calm4git/210043-CO2-Guard/Hardware/Project_KiCad6/CO2Guard/CO2Guard.step

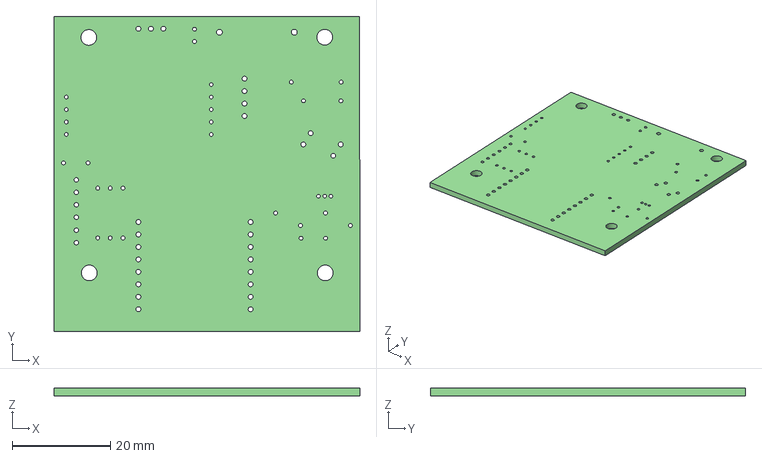
[picture p2: CAD file, 2022-01-18]
Hardware/Project_KiCad6/CO2Guard/CO2Guard.step
62.3 x 64.2 x 1.60 mm
