calm4git/210043-CO2-Guard/Enclosure/Enclosure_R4.FCStd

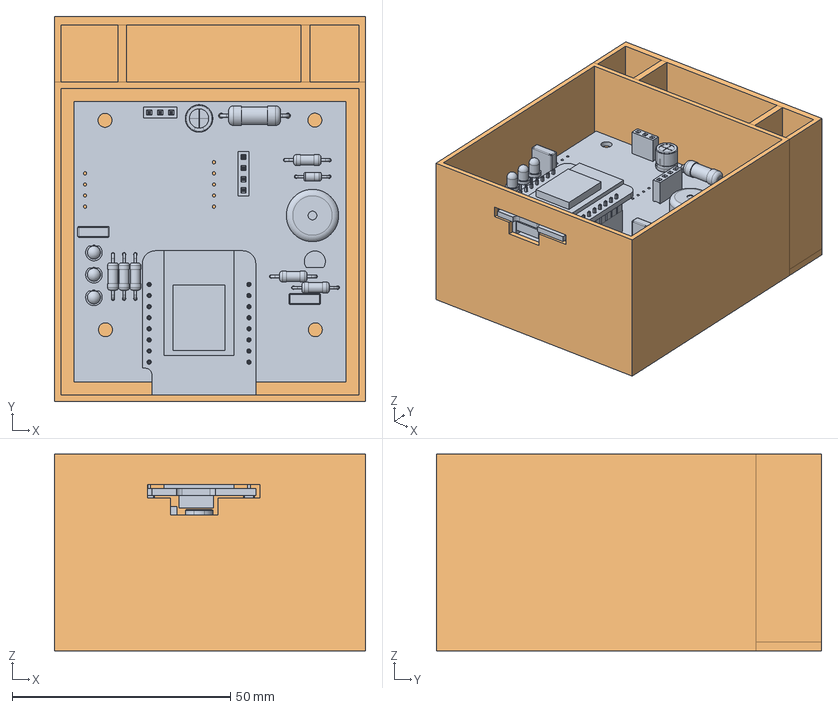
[picture p3: CAD file, 2022-01-18]
Enclosure/Enclosure_R4.FCStd
71.2 x 88.2 x 45.0 mm
PCB
