calm4git/210043-CO2-Guard/Enclosure/Enclosure_R6-Body.stl

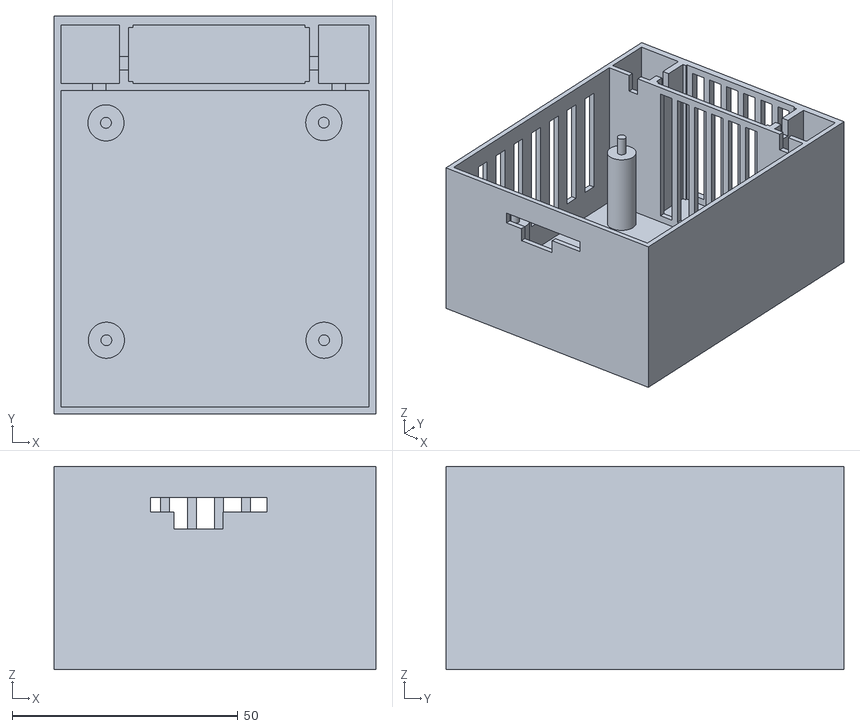
[picture p4: CAD file, 2022-01-18]
Enclosure/Enclosure_R6-Body.stl
71.2 x 88.2 x 45.0
