calm4git/210043-CO2-Guard/Enclosure/Enclosure.FCStd

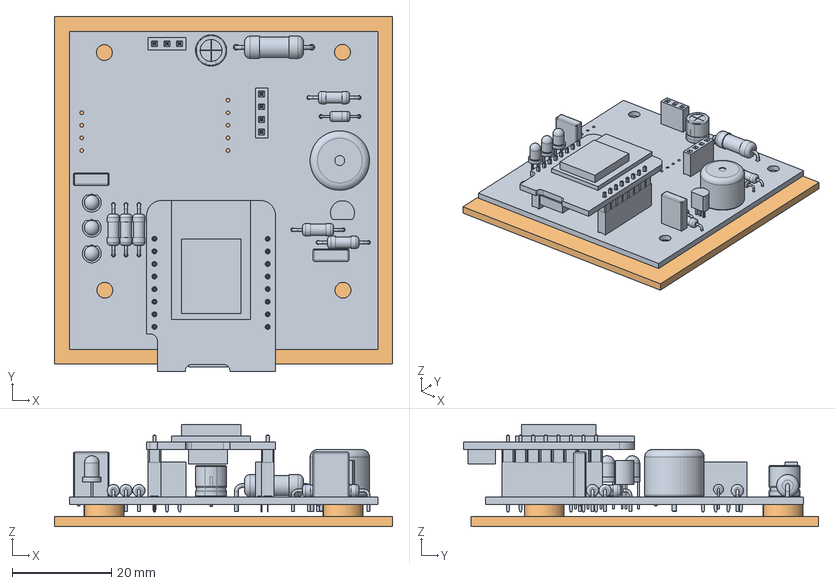
[picture p5: CAD file, 2022-01-18]
Enclosure/Enclosure.FCStd
68.2 x 71.6 x 20.6 mm
PCB
