calm4git/210043-CO2-Guard/Enclosure/PCB.step

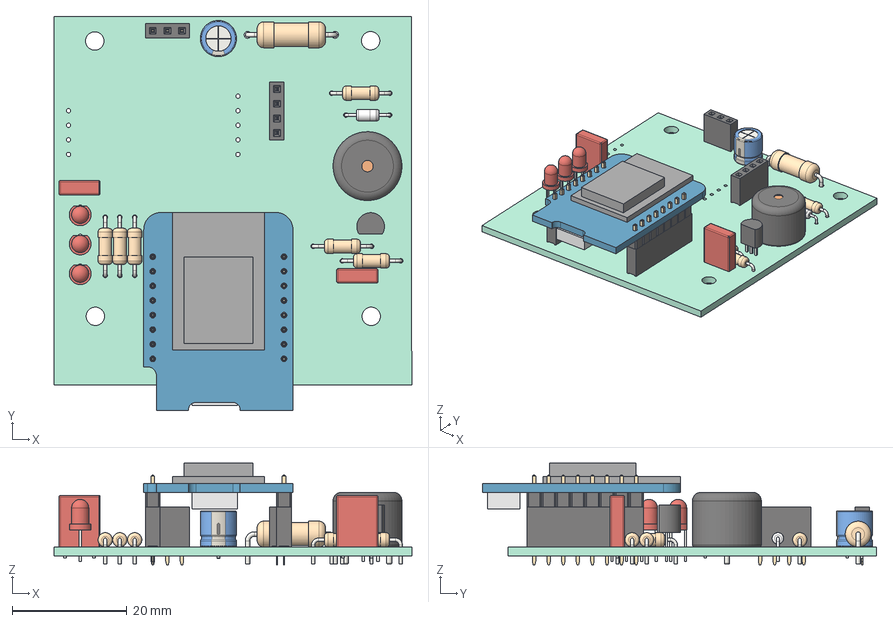
[picture p6: CAD file, 2022-01-18]
Enclosure/PCB.step
62.3 x 68.6 x 17.7 mm
Local_CS_aba2
Pcb_aba2
PCB_Sketch_aba2
R1_R_Axial_DIN0207_L63mm_D25mm_P1016mm_Horizontal_11b1a3e9db61 x 6
D2_LED_D3.0mm_9c0110439fe8 x 3
BZ1_Buzzer_12x95RM76_8608c118e2ea
C3_C_Rect_L72mm_W25mm_P500mm_FKS2_FKP2_MKS2_MKP2_e4ec8c99f59a x 2
MOD2_wemos_d1_mini_light_5af2f70fbb02
MOD2_PinHeader_1x08_P254mm_Vertical_5af2f70fbb02[2] x 2
MOD2_PinSocket_1x08_P254mm_Vertical_5af2f70fbb02[4] x 2
D1_D_DO-35_SOD27_P7.62mm_Horizontal_e6b14dd31fd8
T1_TO-92_Inline_Narrow_a544e0e09d30
C1_CP_Radial_D63mm_P250mm_4de5c4f60304
R3_R_Axial_DIN0414_L119mm_D45mm_P1524mm_Horizontal_521483cc3ac1
K2_PinSocket_1x04_P254mm_Vertical_464553455adc
K1_PinSocket_1x03_P254mm_Vertical_98f3e5fe64bb
