calm4git/210043-CO2-Guard/Enclosure/Enclosure_R2.FCStd

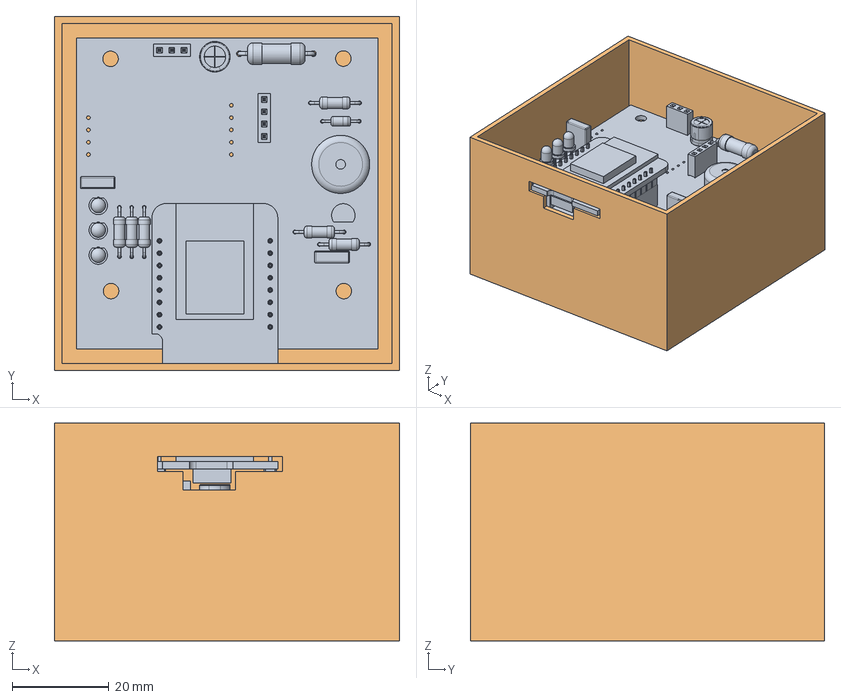
[picture p7: CAD file, 2022-01-18]
Enclosure/Enclosure_R2.FCStd
71.2 x 73.2 x 45.0 mm
PCB
