calm4git/210043-CO2-Guard/Enclosure/Enclosure_R9.FCStd

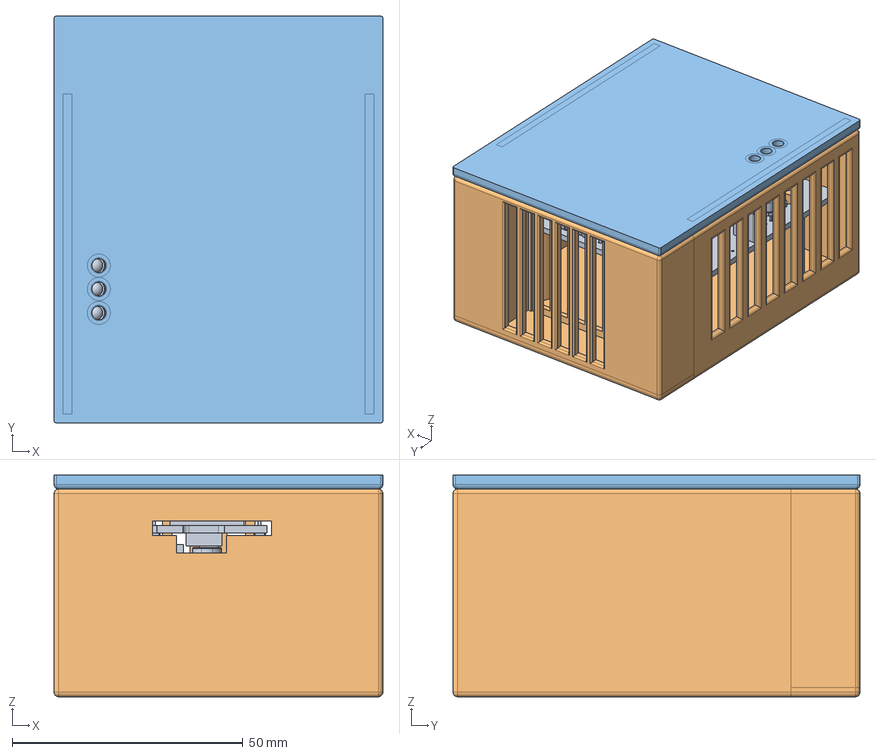
[picture p9: CAD file, 2022-01-18]
Enclosure/Enclosure_R9.FCStd
71.2 x 88.2 x 48.0 mm
PCB
