calm4git/210043-CO2-Guard/(list of files, cad)

Other CAD files:
Enclosure/Enclosure_R1.FCStd
Enclosure/Enclosure_R7.FCStd
Enclosure/Enclosure_R6.FCStd
Enclosure/PCB.stl
