calm4git/210043-CO2-Guard/Hardware/Project_KiCad6/CO2Guard/CO2Guard.kicad_pcb

## KiCad design Hardware/Project_KiCad6/CO2Guard/CO2Guard.kicad_pcb (2022-01-18)

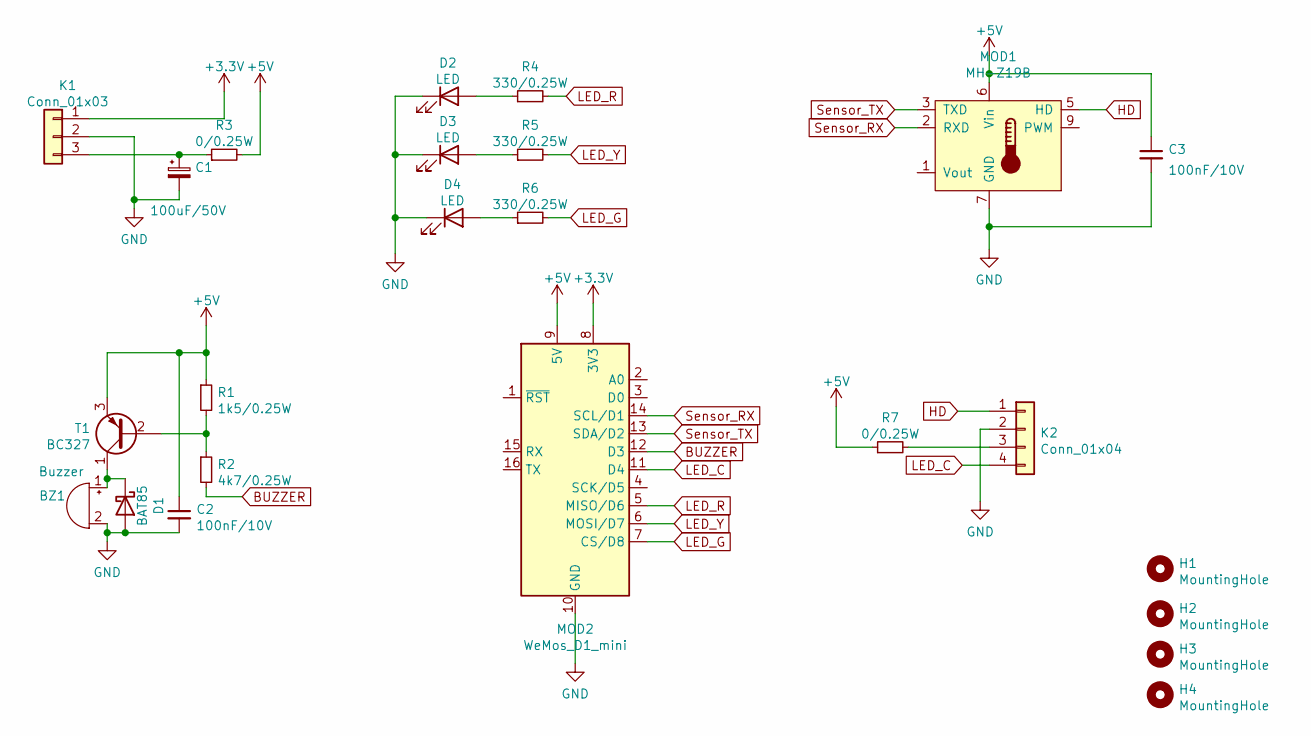
[picture p11: schematic CO2Guard.kicad_sch, Elektor CO2 Guard (210043)]

Parts:
BZ1: Buzzer; Buzzer_12x9.5RM7.6; mpn WT-1205
C1: 100uF/50V; CP_Radial_D6.3mm_P2.50mm; mpn 860020573008
C2, C3: 100nF/10V; C_Rect_L7.2mm_W2.5mm_P5.00mm_FKS2_FKP2_MKS2_MKP2; mpn MKS2C031001A00KSSD
D1: BAT85; D_DO-35_SOD27_P7.62mm_Horizontal; mpn BAT85S-TR
D2: LED; LED_D3.0mm; mpn 151031SS04000
D3: LED; LED_D3.0mm; mpn 151031YS06000
D4: LED; LED_D3.0mm; mpn 151031VS06000
H1, H2, H3, H4: MountingHole; MountingHole_3.2mm_M3
K1: Conn_01x03; PinSocket_1x03_P2.54mm_Vertical
K2: Conn_01x04; PinSocket_1x04_P2.54mm_Vertical
MOD1: MH-Z19B; Winsen_MH-Z19B
MOD2: WeMos_D1_mini; WEMOS_D1_mini_light
R1: 1k5/0.25W; R_Axial_DIN0207_L6.3mm_D2.5mm_P10.16mm_Horizontal; mpn LR0204F1K5
R2: 4k7/0.25W; R_Axial_DIN0207_L6.3mm_D2.5mm_P10.16mm_Horizontal; mpn CFR-25JB-52-4K7
R3: 0/0.25W; R_Axial_DIN0414_L11.9mm_D4.5mm_P15.24mm_Horizontal; mpn ZR0207C
R4, R5, R6: 330/0.25W; R_Axial_DIN0207_L6.3mm_D2.5mm_P10.16mm_Horizontal; mpn MBA02040C3300FRP00
R7: 0/0.25W; R_Axial_DIN0207_L6.3mm_D2.5mm_P10.16mm_Horizontal; mpn ZR0207C
T1: BC327; TO-92_Inline; mpn BC32725BU

Connections:
+3V3: K1.1, MOD2.8 (3V3)
+5V: C2.1, C3.1, MOD1.6 (Vin), MOD2.9 (5V), R1.1, R3.2, R7.1, T1.3 (E)
BUZZER: MOD2.12 (D3), R2.2
GND: BZ1.2 (+), C1.2, C2.2, C3.2, D1.2 (A), D2.1 (K), D3.1 (K), D4.1 (K), K1.2, K2.2, MOD1.7 (GND), MOD2.10 (GND)
HD: K2.1, MOD1.5 (HD)
LED_C: K2.4, MOD2.11 (D4)
LED_G: MOD2.7 (CS/D8), R6.2
LED_R: MOD2.5 (MISO/D6), R4.2
LED_Y: MOD2.6 (MOSI/D7), R5.2
unnamed: BZ1.1 (-), D1.1 (K), T1.1 (C)
unnamed: C1.1, K1.3, R3.1
unnamed: D2.2 (A), R4.1
unnamed: D3.2 (A), R5.1
unnamed: D4.2 (A), R6.1
unnamed: K2.3, R7.2
unnamed: R1.2, R2.1, T1.2 (B)
Sensor_RX: MOD1.2 (RXD), MOD2.14 (SCL/D1)
Sensor_TX: MOD1.3 (TXD), MOD2.13 (SDA/D2)

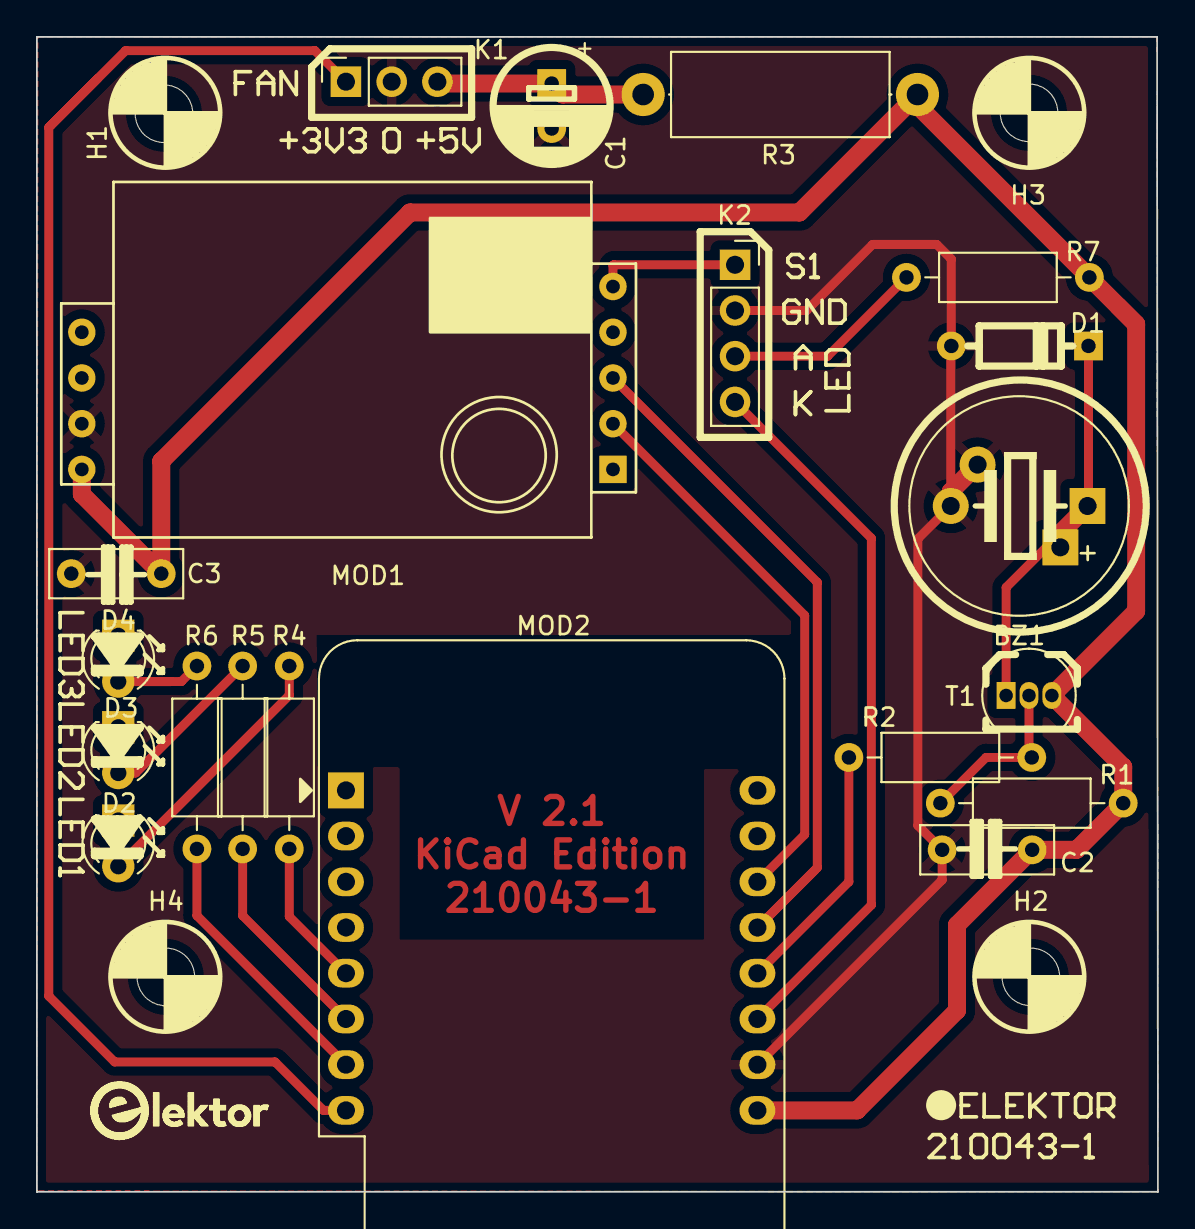
[picture p12: board CO2Guard.kicad_pcb from above]

Board: 2 copper layers, 62.3 x 64.2 mm, 24 parts (0 on the bottom side), 18 nets.
