calm4git/210043-CO2-Guard/(commit log)

2022-01-13 added MPN to schematic parts
    [CO2Guard.kicad_pcb, CO2Guard.kicad_sch]
2022-01-18 Added Enclosure
    [CO2Guard.csv, CO2Guard.kicad_pcb, CO2Guard.kicad_sch, CO2Guard.step, CO2Guard.xls, Enclosure.FCStd, Enclosure_R1.FCStd, Enclosure_R2.FCStd]
